dragonlost/ArduiStepFocuser/Documentations/BOM_ArduiStepFocuser.xlsx

ID | Name | Designator | Quantity | Manufacturer Part | Manufacturer | Digi-Key | Mouser | Note
1 | DC005-2.5MM | P1 | 1 | PJ-002B | CUI Inc | CP-002B-ND | 490-PJ-002B
2 | L7809CV | U4 | 1 | L7809CV | ST | 497-1448-5-ND | 511-L7809CV
3 | FUSE | F1 | 1 | 3568 | Keystone | 36-3568-ND | 534-3568
4 | DRV8825 Stepper Motor Driver Carrier | U1 | 1 | n/a | n/a | n/a | n/a | A choisir
5 | Arduino | U2 | 1 | A000005 | Arduino | 1050-1001-ND | 992-ARD-NANO30
6 | 172316-1110 | U3 | 1 | M20-9760546 | Harwin | 952-1795-ND | 855-M20-9760546
7 | 1MΩ | R2 | 1 | MFR-25FBF52-1M | Yageo | 1.00MXBK-ND | 603-CFR-25JT-52-1M
8 | 1.2KΩ | R4,R10,R11 | 2 | MFR0W4F1201A50 | Yageo | 1.2KQBK-ND | 603-CFR-25JR-521K2
9 | 80SQ045 | D1 | 1 | MBR1060G | ON Semiconductor | MBR1060GOS-ND | 863-MBR1060G
10 | 100nF | C1,C2,C3 | 2 | C320C104K5R5TA7301 | KEMET | 399-4264-ND | 80-C320C104K5R7301 | Ref differente entre digikey et Mouser
11 | 470uF | C4 | 1 | EEU-FM1H471 | Panasonic | P12400-ND | 667-EEU-FM1H471
12 | BUZZER | SG1 | 1 | CEM-1203(42) | CUI | 102-1153-ND | 490-CEM-1203(42)
13 | 10KΩ | R1,R3 | 2 | CFR-25JT-52-10K | Yageo | 10.0KXBK-ND | 603-CFR-25JT-52-10K
14 | 100Ω | R5 | 1 | CFR-25JB-52-100R | Yageo | 100QBK-ND | 603-CFR-25JT-52-100R
15 | 560Ω | R6,R7 | 2 | CFR-25JB-52-560R | Yageo | 560QBK-ND | 603-CFR-25JB-52-560R
16 | 4.7KΩ | R9 | 1 | CFR-25JR-52-4K7 | Yageo | 4.7KQBK-ND | 603-CFR-25JR-524K7
17 | 100uF | C5 | 1 | ECA-1HM101 | Panasonic | P5182-ND | 667-ECA-1HM101B
18 | MOLEX KK 1X4 | J1 | 1 | 22-23-2041 | Molex | WM4202-ND | 538-22-23-2041
19 | 10nF | C6,C7 | 2 | C317C103K5R5TA | KEMET | 399-4206-ND | 80-C317C103K5R
20 | MOLEX 1X3 LOCKING | J3,J4 | 2 | 22-23-2031 | Molex | WM4201-ND | 538-22-23-2031
21 | Yellow | LED1 | 1 | n/a | n/a | n/a | n/a | A trouver
22 | RED | LED2 | 1 | n/a | n/a | n/a | n/a | A trouver
24 | MOLEX KK 1X5 | J5 | 1 | 22-23-2051 | Molex | WM4203-ND | 538-22-23-2051
25 | 1x1 Header | JP1,JP2,JP3,JP4 | 4 | 68000-401HLF | Amphenol FCI | 609-3466-ND | 649-68000-401HLF
26 | 1x2 Header, M0,M1,M2,M3 | J2,J6,JP5,JP6,JP7,JP8,JP9 | 7 | M20-9990246 | Harwin | 952-2262-ND | 855-M20-9990246
27 | SWITCH | U5 | 1 | n/a | n/a | n/a | n/a | A trouver
34 | Jumper | JP9,8,7,6,5 | 10 | 382811-6 | TE Connectivity | S9001-ND | 571-382811-6 | Ref differente entre digikey et Mouser
35 | Arduino (bis) | U2 | 1 | DFR0010 | DFRobot | 1738-1026-ND | 426-DFR0010
