dragonlost/ArduiStepFocuser/(threads)

Thread 1 (2018-06-03):

Need add command for compatibilty with 1.72 myfocuserpro

dragonlost, 2018-06-03:
Need add Command :

- MR -> use
- MU and MT-> use
- PG and PS-> use
- PM and PN ( replace SU)->use
- PP and PR->not use
- MV and MW->not use
- MX->use
- TA->use
- SX and GX->not use
- PZ->not use
- PQ->use

dragonlost, 2018-06-04:
- MR -> Get motor Speed **-> use**
- MU and MT -> Get/Set MotorSpeed Threshold  **-> not use**
- PG and PS -> Get/Set temperature precision **-> use**
- PN and PM ( replace SU) -> get/set update of position on lcd when moving **->use**
- PR and PP -> Get/Set the step size value **-> not use**
- MW and Mv Get/Set Enable/Disable motorspeed change when moving **->not use**
- MX -> Save settings to EEPROM **-> use**
- TA- > Reboot Arduino **-> use**
- GX and SX -> Get/Set updatedisplayNotMoving (length of time an LCD page is displayed for in milliseconds **-> not use**
- PQ and PZ Get/Set the return of user specified stepsize to be OFF - default (0) or ON (1) **-> not use**

dragonlost, 2018-06-04:
Command : MU, MW, GX, PG, PN, PQ need for use Windows app
