dragonlost/ArduiStepFocuser/Documentations/Schematic_ArduiStepFocuser_2020-10-17_16-06-04.pdf

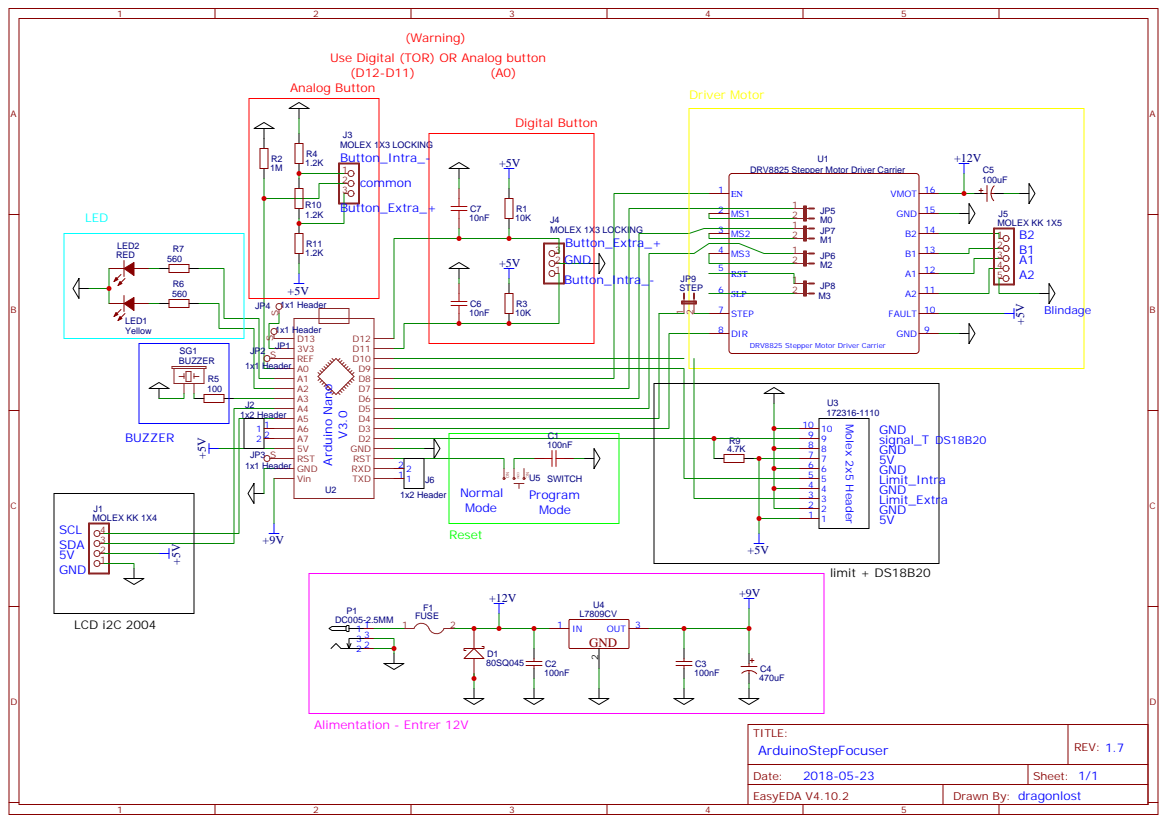
[picture p9: page 1]

Use Digital (TOR) OR Analog button

DRV8825 Stepper Motor Driver Carrier
