dragonlost/ArduiStepFocuser/(commit log)

2017-10-31 add tuto for arduino library
2017-10-31 correct tuto for arduino library
2018-11-05 Add BOM file
    [BOM_ArduiStepFocuser.xlsx]
2018-11-05 update BOM
    [BOM_ArduiStepFocuser.xlsx]
